cs684-2018/Smart-Fault-Monitoring-Device/Documentation/Presentation/SFMD_Proj_Presentation.pdf

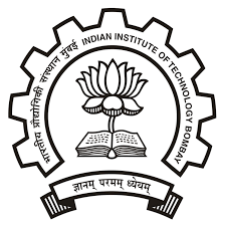
[picture p19: figure]

# Smart Fault Monitoring Device

Guide
Prof. Kavi Arya
Mr. Naveen Cherupally

Group Members
Abhishek Pal -173074015
Anil Kumar Garg -173074018

CS 684 - Embedded Systems
Spring 2018

## Problem Statement

Objective

- A Smart Fault Monitoring Device can be used for monitoring the trip/fault status across MCB in domestic and industrial safety application.
- This will log trip information and intimate to user using IoT device.

Product Impact

- All residential and commercial establishments.
- Be a part of Smart City initiative.

## Scheme

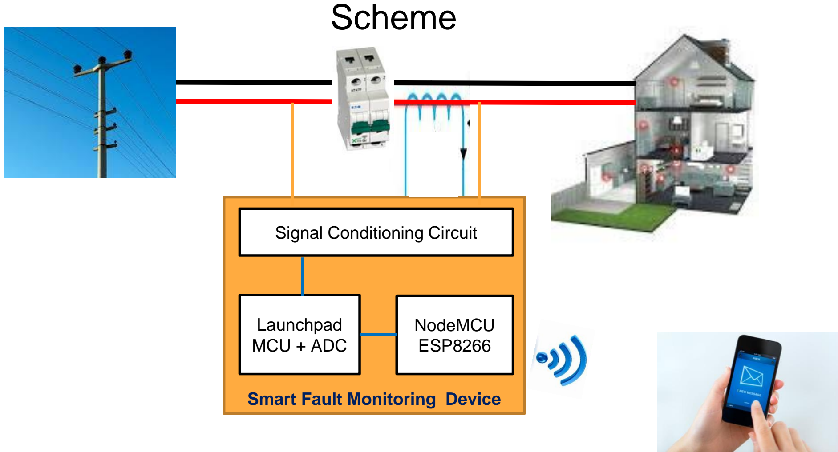
[picture p20: page 3]

Smart Fault Monitoring Device

Launchpad
MCU + ADC

Signal Conditioning Circuit

NodeMCU
ESP8266

## Actual Product Realized

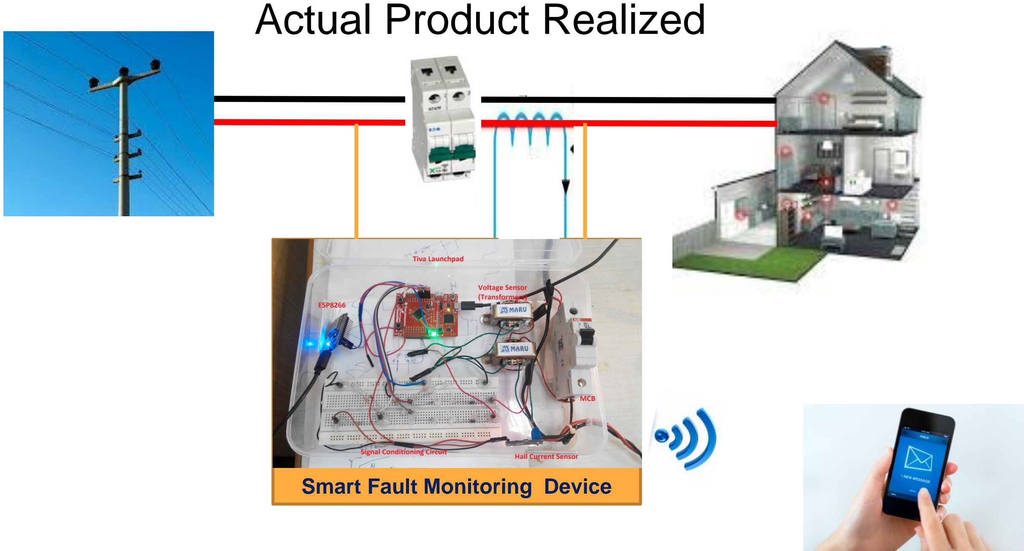
[picture p21: page 4]

Smart Fault Monitoring Device

Launchpad
MCU + ADC

Signal Conditioning Circuit

NodeMCU
ESP8266

## Signal Conditioning

## Schematic

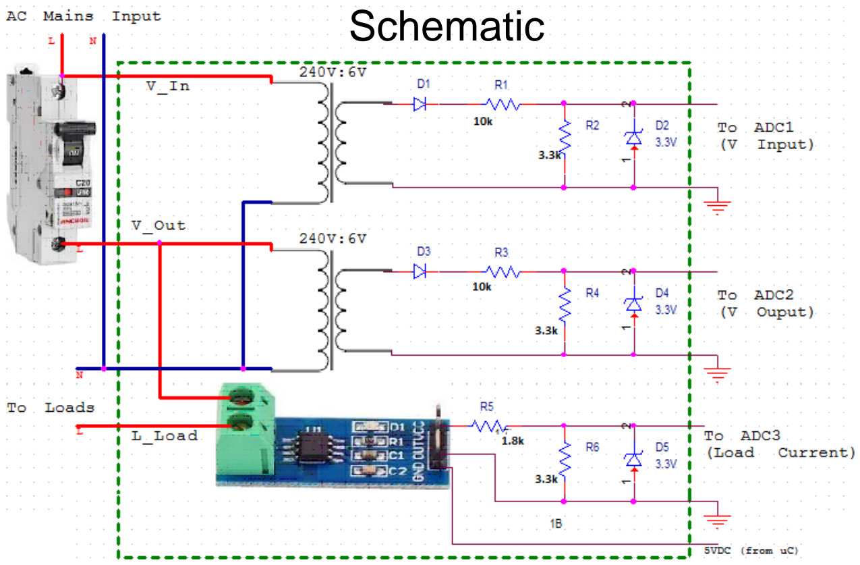
[picture p22: page 5]

## Power Status Monitoring

- Power OK : Voltages on Primary & Secondary side of MCB are OK.
- No Power: Mains supply is not coming.
- MCB Tripped: MCB got tripped due to overcurrent, short circuit etc.

## Requirements

Hardware
- ESP8266 NodeMCU
- Tiva Series Launchpad
- AC Voltage Sensor (Step down Transformer)
- AC Current Sensor (ACS712)
- Signal Conditioning Board
- 5VDC Supply

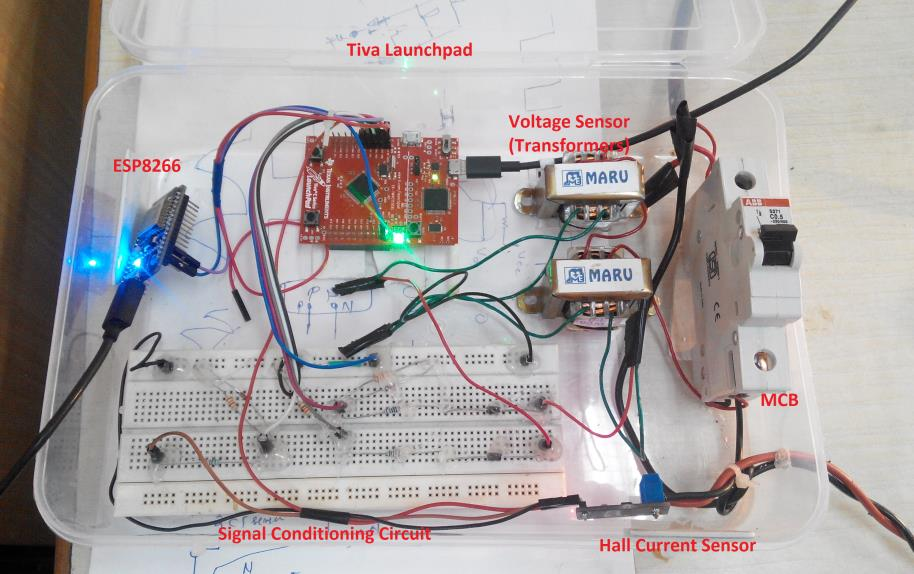
[picture p23: figure]

Software
- CCS 6.1.2
- MOS (for IoT Device)
- AWS Platform (e-yantra)
- Serial Console

## Challenges

Challenges
- Safety precaution to be followed, while working with live voltages.
- Hardware selection for Wireless communication.
- Sensor selection for AC current and voltage.
- Sensor calibration
- Real time DC offset calibration.
- Exploring web/email interface for user notification
- Acquiring the skills for the IoT device programming (MOS/mJS)

## Deliverables

- Smart Fault Monitoring Unit
- Microcontroller board with ADC/sensors
- IoT device
- Analog signal conditioning hardware
- Front-end interface(IoT platform)

## Test Strategies

- Measurement Tests : To verify measured input current and voltage values
- Fault Monitoring and Test : To verify the detection of MCB trip contact status
- Communication Test: Send the fault/trip alert to the user via internet/AWS
- Front-end testing

## Test Results ..1

- ACS712 - 30A Current

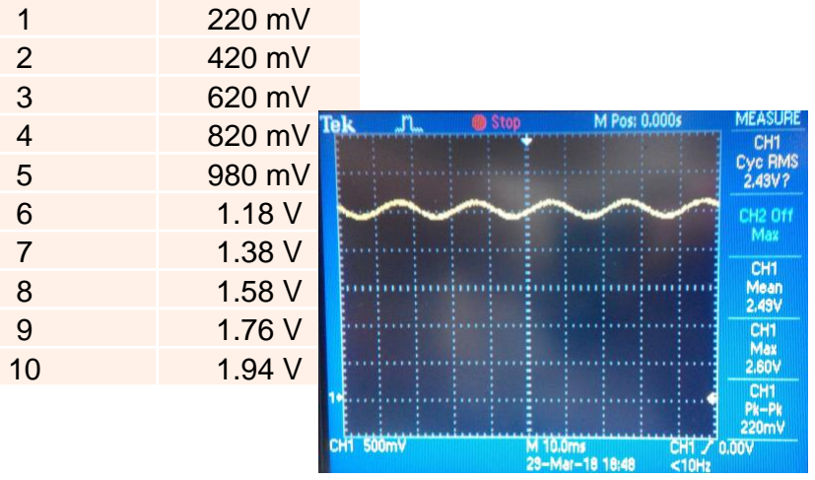
[picture p24: figure]

Sensor

Ip (Input), Amp (rms) | Sensor O/P Volt (Vpp)
0.25 | 56.8mV
0.5 | 101mV
- Voltage Sensor

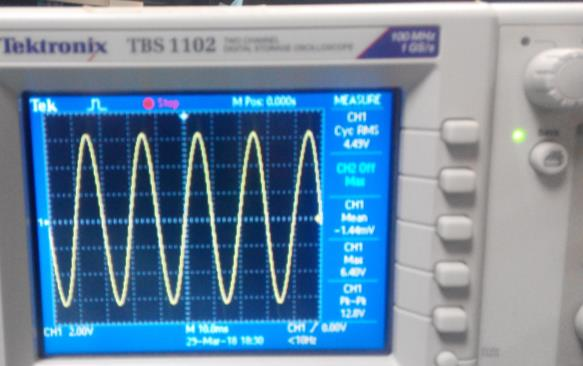
[picture p25: figure]

Primary Volt | Secondary Volt
240 Vrms | +/-10.6 V

## Test Results ..2

- Tiva | ● ESP
Timer Interrupt Generation & Verification | Done
ADC SoC Generation & Data read Verify | Done
Volt/Current RMS calculation logic | Done
Fault status decoding logic | Done
Fault intimation on UART | Done

ESP8266
Arduino IDE & library installation | Done
ESP programming procedure | Done
ESP UART communication with Tiva | Done
ESP Wifi Comm. | Done
ESP Notification Sending | Done
Web/Email | Done
IoT Platform (AWS) Interface | Done

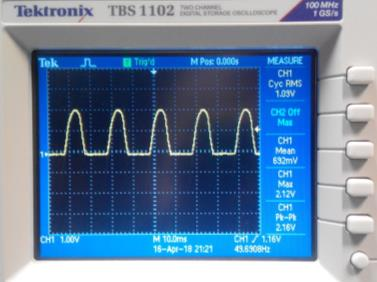
[picture p26: figure]
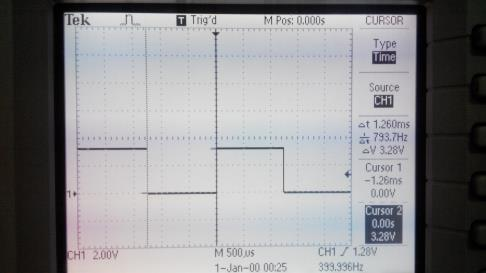
[picture p27: figure]
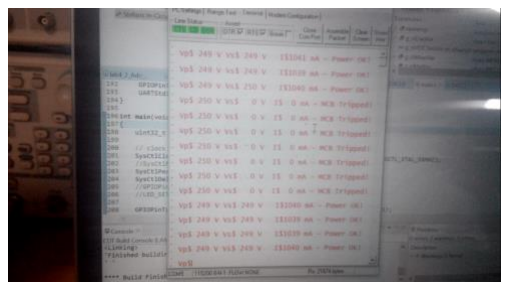
[picture p28: figure]

## Integrated Test Setup

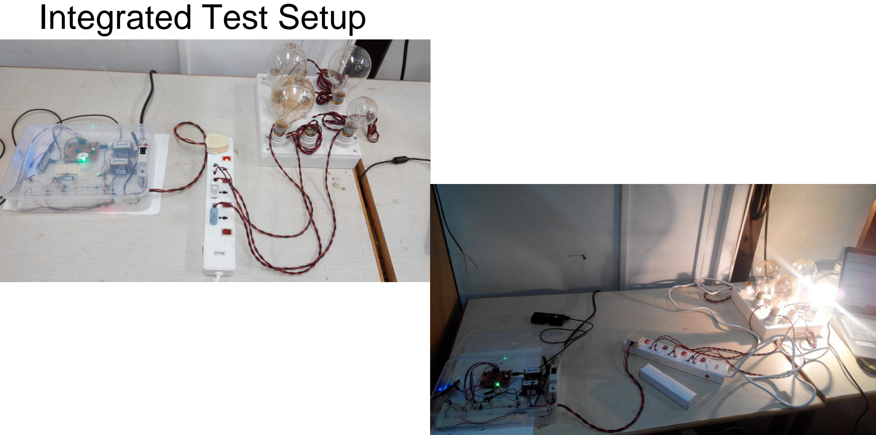
[picture p29: page 13]

## Dashboard (Power OK - Normal State)

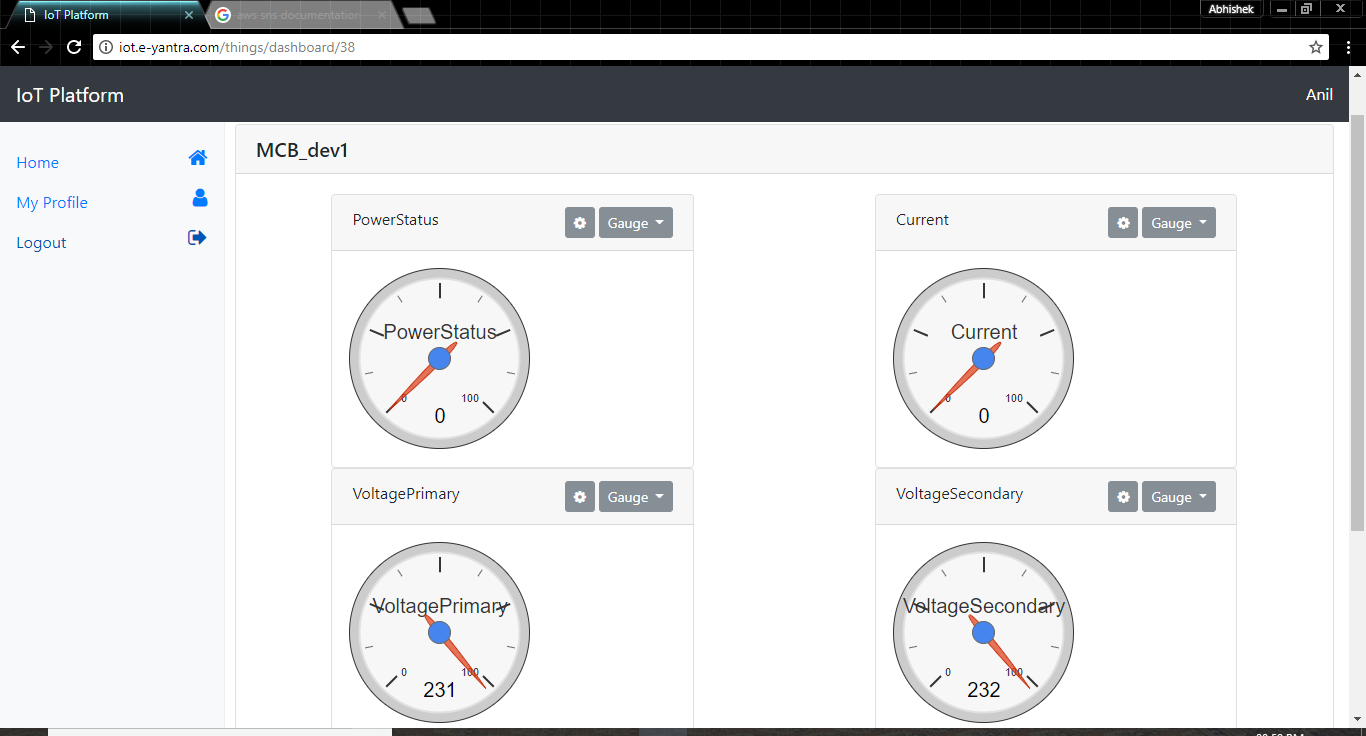
[picture p30: figure]

## Dashboard (No Power State)

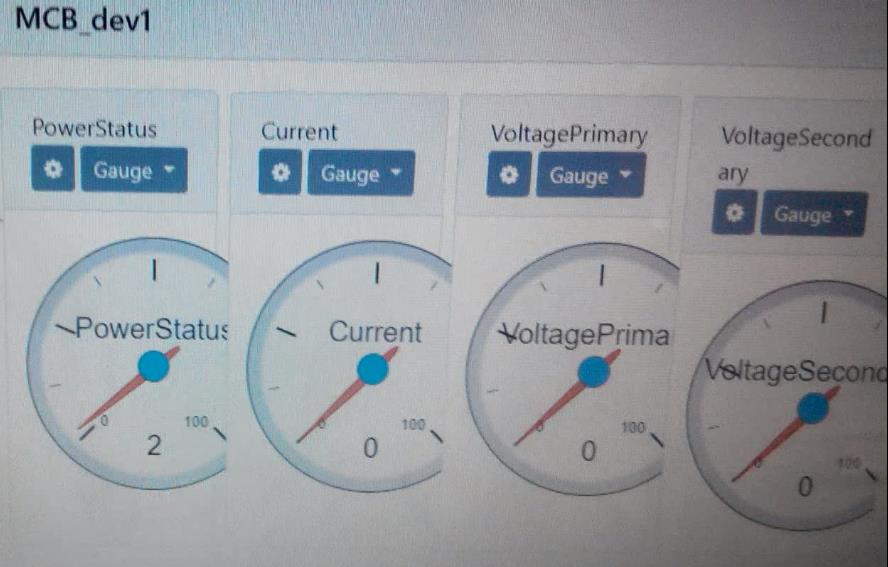
[picture p31: figure]

## Dashboard (MCB Tripped State)

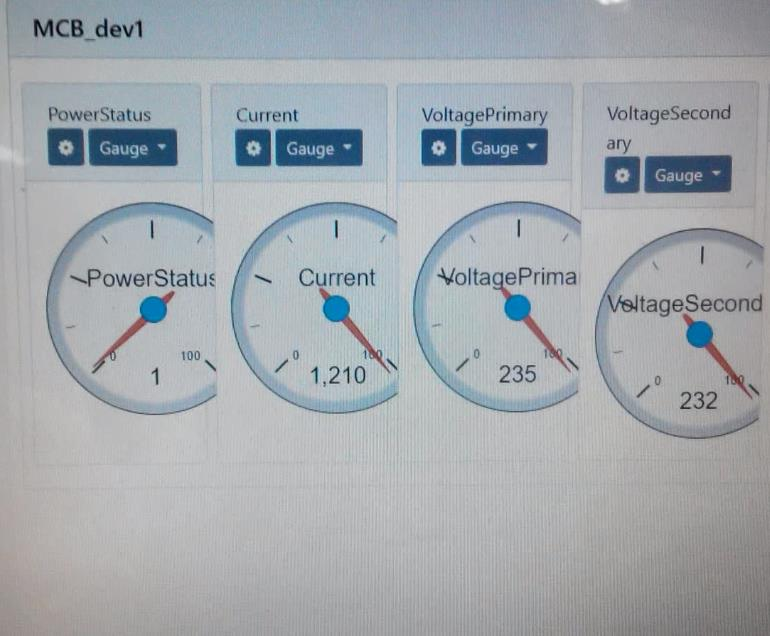
[picture p32: figure]

## Alternate Dashboard (Time History – Normal State)

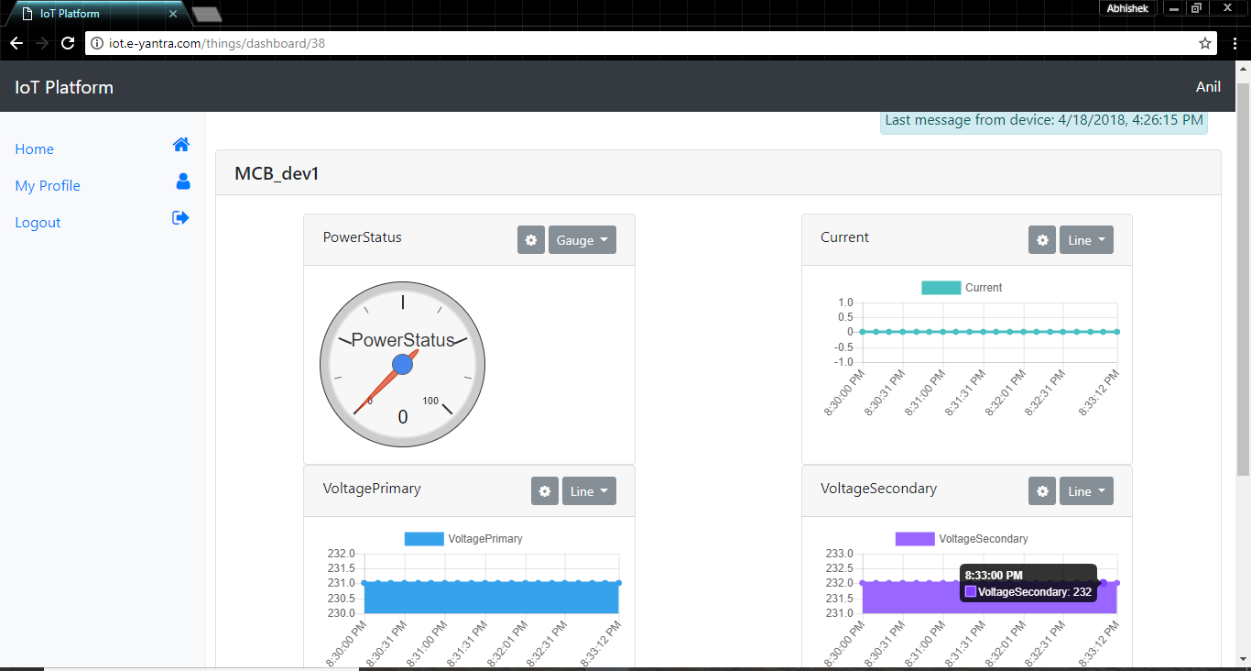
[picture p33: page 17]

## Email Notifications

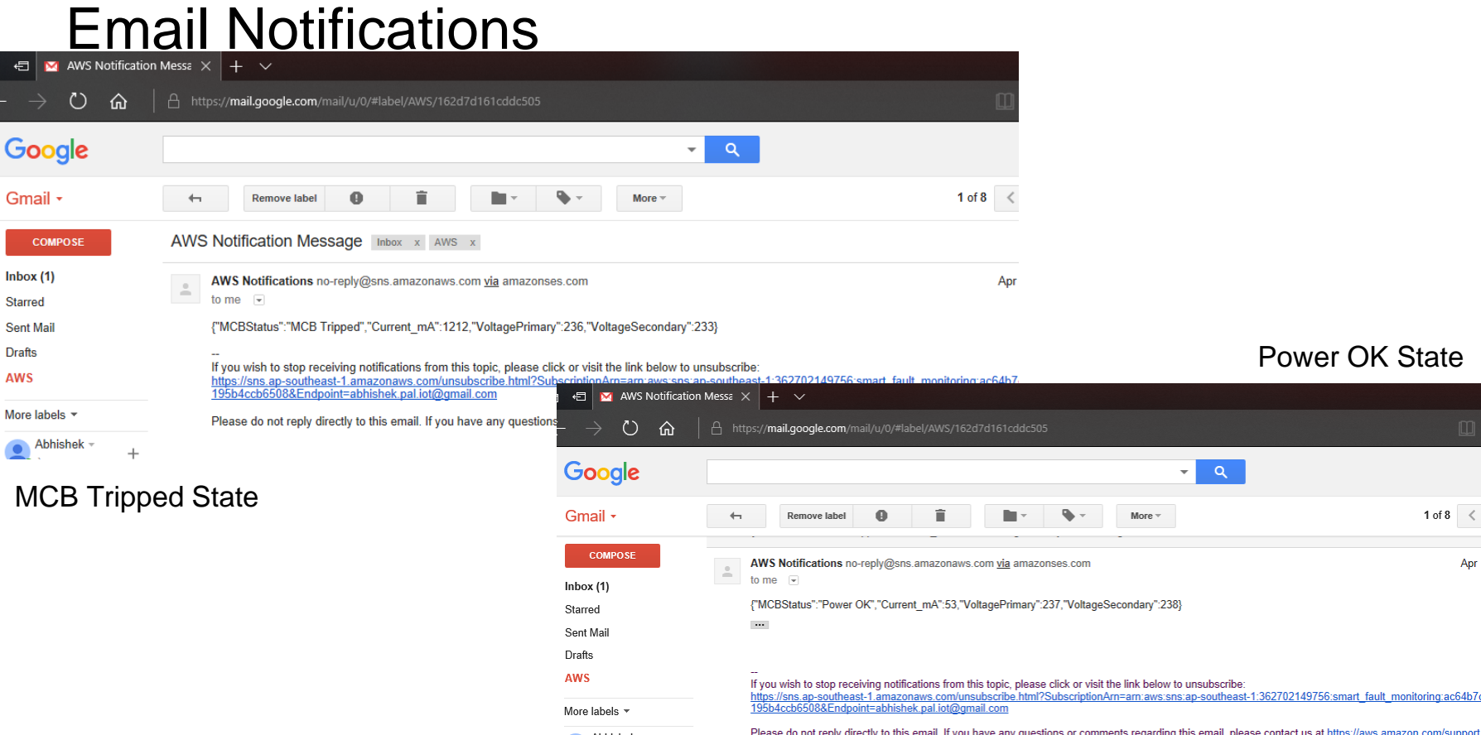
[picture p34: page 18]

MCB Tripped State

Power OK State

## Timeline

Activity | Timeline (EDC)
Project Discussion & Finalisation | 2 nd Week – March’18
Component & Sensor Selection | 3 rd Week – March’18
Component & Sensor Ordering & Receipt | 3 rd- 4 th Week – March’18
Component/Sensor Testing | th Week – March’18 4-5
Coding & testing – Microcontroller (measurement & processing) | 4-5 th Week – March’18
Communication with microcontroller & IoT device | 1 st Week – April’18
Front-end development & communication with IoT | 2 nd Week – April’18
Integrated Testing | 3 rd Week – April’18
Final Presentation | 18th April, 2018

## Expected output & Status

- Real time data acquisitions of current and voltage : Done
- MCB contact monitoring : Trip or No trip : Done
- Data display on e-yantra IoT platform : Done
- Alert message to user : Done

## Approach

- Real time data acquisitions of current and voltage :
- Collected 16 samples/ cycle (20 millisecond time) and calculated RMS value
- Buffered all samples of all channels for debugging purpose.
- Calibration of all current and voltage channels.
- Runtime DC offset removal logic from input AC signal
- Latching data whenever fault occurs
- MCB contact monitoring :
- Implemented logic to derive MCB tripped /power supply status

Approach..

- Data display on e-yantra IoT platform
- Acquiring the skills for the IoT device programming (MOS/mJS)
- Establishing internet communication of ESP8266 with e-yantra/AWS using MOS
- Communication interface between ESP8266 and TIVA board
- Massage frame formatting and parsing data into JSON string format.
- Sending data from Tiva to ESP via UART.
- Alert message to user
- E-yantra IoT platform (AWS SNS service)
- Email notification

## Issue Faced

- Synchronization issue of latched data with pre tripped input signal.
- Exploring options for programming the ESP (Arduino/Mongoose OS)
- String parsing in mJS & extracting the parameter values
- ESP UART0 is driven by USB & GPIO both. Only one can drive at a time.
- UART0 also used for system message logs. So ‘SetDispatcher’ API stops triggering, once ESP connects to WiFi. Otherwise in offline condition it was working
- Resolution: Used polling method by a timer to read UART data & flush the UART buffer for next reception
- I2C in master mode tested, but had some issues of interrupt handling using Tiva as I2C slave.
- Some times IoT (e-yantra/AWS) server link was down (mostly in evening time). However it was restored later on.

## Feature Enhancement

- Android application for easily accessibility
- Universal device for all rating of MCBs
- OTA (Remote firmware upgrade)
- Oscillography during tripping
- Data logging
- Higher precise power analyser for metering application
- Earth fault monitoring system

# Thank You
