cs684-2018/Smart-Fault-Monitoring-Device/Lab Experiments/readme.txt

member1
Name: Abhishek Pal (173074015)

member2
Name: Anil Garg (173074018)

All the lab experiments done areuploaded in respective member's folder
Folders are named as student_roll_no.
Added a well documented and commented code of your experiments in the respective folders.

(Note: These lab exeperiments were already being uploaded in respective member's github
repository after conducting each lab experiments).
