cs684-2018/Smart-Fault-Monitoring-Device/(list of files, drawings)

Other design files:
Documentation/Schematic/SFMD_Schematic.DSN
