cs684-2018/Smart-Fault-Monitoring-Device/Lab Experiments/173074015_Abhishek/Experiment3/LAB3P2.c

/*

Name: Anil Kumar Garg : 173074018
Name: Abhishek Pal : 173074015

Course Name: CS684-2018

Problem: 

1. When switch 1 is pressed the motor should rotate by ten degrees clockwise.
2. When switch 2 is pressed the motor should rotate by ten degrees anti-clockwise.
3. While doing the above two actions check for limits of the servo motor. It should no
move beyond the operating range.
4. Also use the debouncing method that you have learned in lab 2 for interfacing the
switch.


 */

#include <stdint.h>
#include <stdbool.h>
#include "inc/hw_memmap.h"
#include "inc/hw_types.h"
#include "driverlib/sysctl.h"
#include "driverlib/gpio.h"
#include "driverlib/debug.h"
#include "driverlib/pwm.h"
#include "driverlib/pin_map.h"
#include "inc/hw_gpio.h"
*/

volatile uint8_t ui8Adjust;

#define PWM_FREQUENCY 55
int main(void)
{
	volatile uint32_t ui32Load;
	volatile uint32_t ui32PWMClock;

	ui8Adjust = 83;
	SysCtlClockSet(SYSCTL_SYSDIV_5|SYSCTL_USE_PLL|SYSCTL_OSC_MAIN|SYSCTL_XTAL_16MHZ);
	SysCtlPWMClockSet(SYSCTL_PWMDIV_64);
	SysCtlPeripheralEnable(SYSCTL_PERIPH_PWM1);
	SysCtlPeripheralEnable(SYSCTL_PERIPH_GPIOD);
	SysCtlPeripheralEnable(SYSCTL_PERIPH_GPIOF);
	GPIOPinTypePWM(GPIO_PORTD_BASE, GPIO_PIN_0);
	GPIOPinConfigure(GPIO_PD0_M1PWM0);
	HWREG(GPIO_PORTF_BASE + GPIO_O_LOCK) = GPIO_LOCK_KEY;
	HWREG(GPIO_PORTF_BASE + GPIO_O_CR) |= 0x01;
	HWREG(GPIO_PORTF_BASE + GPIO_O_LOCK) = 0;
	GPIODirModeSet(GPIO_PORTF_BASE, GPIO_PIN_4|GPIO_PIN_0, GPIO_DIR_MODE_IN);
	GPIOPadConfigSet(GPIO_PORTF_BASE, GPIO_PIN_4|GPIO_PIN_0, GPIO_STRENGTH_2MA, GPIO_PIN_TYPE_STD_WPU);
	ui32PWMClock = SysCtlClockGet() / 64;
	ui32Load = (ui32PWMClock / PWM_FREQUENCY) - 1;
	PWMGenConfigure(PWM1_BASE, PWM_GEN_0, PWM_GEN_MODE_DOWN);
	PWMGenPeriodSet(PWM1_BASE, PWM_GEN_0, ui32Load);
	PWMPulseWidthSet(PWM1_BASE, PWM_OUT_0, ui8Adjust * ui32Load / 1000);
	PWMOutputState(PWM1_BASE, PWM_OUT_0_BIT, true);
	PWMGenEnable(PWM1_BASE, PWM_GEN_0);
	while(1)
	{
		if( GPIOPinRead(GPIO_PORTF_BASE,GPIO_PIN_4)==0x00)
		{
			ui8Adjust--;
			if (ui8Adjust < 56)
			{
				ui8Adjust = 56;
			}
			PWMPulseWidthSet(PWM1_BASE, PWM_OUT_0, ui8Adjust * ui32Load / 1000);
		}
		if( GPIOPinRead(GPIO_PORTF_BASE,GPIO_PIN_0)==0x00)
		{
			ui8Adjust++;
			if (ui8Adjust > 111)
			{
				ui8Adjust = 111;
			}
			PWMPulseWidthSet(PWM1_BASE, PWM_OUT_0, ui8Adjust * ui32Load / 1000);
		}
		SysCtlDelay(100000);
	}
}


void Timer0IntHandler(void)
{

}
void Timer1IntHandler(void)
{

}


void Timer2IntHandler(void)
{

}
