cs684-2018/Smart-Fault-Monitoring-Device/Lab Experiments/173074015_Abhishek/Experiment4/lab4_Adc_Uart.c

/*
 * Course : CS-684
 * Lab 4 : Joystick reading with Adc & Send to UART 
 * Submitted By:
 *            Abhishek Pal: Roll# 173074015
 *			  Anil Garg : Roll# 173074018
 */

#include <stdio.h>
#include <stdint.h>
#include <stdbool.h>
#include "inc/hw_ints.h"
#include "inc/hw_memmap.h"
#include "inc/hw_types.h"
#include "driverlib/sysctl.h"
#include "inc/tm4c123gh6pm.h"
#include "driverlib/interrupt.h"
#include "driverlib/gpio.h"
#include "driverlib/timer.h"
#include "driverlib/systick.h"
#include "driverlib/adc.h"
#include "driverlib/rom.h"
#include "driverlib/debug.h"
#include <time.h>
#include <inc/hw_gpio.h>
#include "driverlib/ssi.h"
#include "driverlib/uart.h"


#define DISCRETE 0

uint32_t ui32ADC0Value[4];
uint32_t ui32ADC1Value[4];

volatile uint32_t ui32Avg0;
volatile uint32_t copy0;

volatile uint32_t ui32Avg1;
volatile uint32_t copy1;

volatile uint8_t digit0;
volatile uint8_t digit1;
volatile uint8_t digit2;
volatile uint8_t digit3;
volatile uint8_t digit4;
volatile uint8_t digit5;
volatile uint8_t digit6;
volatile uint8_t digit7;

void uart_char(char data)
{
    UARTCharPut(UART0_BASE, data);
}

int main(void) {
    // Disable Buzzer on PortC PIN4
    SysCtlPeripheralEnable(SYSCTL_PERIPH_GPIOC); //PortC GPIO
    GPIOPinTypeGPIOOutput(GPIO_PORTC_BASE, GPIO_PIN_4);
    GPIOPinWrite(GPIO_PORTC_BASE, GPIO_PIN_4, 0x10);

    //Set Peripherals
    SysCtlClockSet(SYSCTL_SYSDIV_5|SYSCTL_USE_PLL|SYSCTL_OSC_MAIN|SYSCTL_XTAL_16MHZ);
    SysCtlPeripheralEnable(SYSCTL_PERIPH_ADC0); //Adc0
    SysCtlPeripheralEnable(SYSCTL_PERIPH_ADC1); //Adc1

    // ADCHardwareOversampleConfigure(ADC0_BASE, 64);

    // Set ADC0 Sequencer, Priority , Ch#
    ADCSequenceConfigure(ADC0_BASE, 1, ADC_TRIGGER_PROCESSOR, 0);
    ADCSequenceStepConfigure(ADC0_BASE, 1, 0, ADC_CTL_CH6);
    ADCSequenceStepConfigure(ADC0_BASE, 1, 1, ADC_CTL_CH6);
    ADCSequenceStepConfigure(ADC0_BASE, 1, 2, ADC_CTL_CH6);
    ADCSequenceStepConfigure(ADC0_BASE,1,3,ADC_CTL_CH6|ADC_CTL_IE|ADC_CTL_END);
    ADCSequenceEnable(ADC0_BASE, 1);

    // Set ADC1 Sequencer, Priority, Ch#
    ADCSequenceConfigure(ADC1_BASE, 1, ADC_TRIGGER_PROCESSOR, 0);
    ADCSequenceStepConfigure(ADC1_BASE, 1, 0, ADC_CTL_CH7);
    ADCSequenceStepConfigure(ADC1_BASE, 1, 1, ADC_CTL_CH7);
    ADCSequenceStepConfigure(ADC1_BASE, 1, 2, ADC_CTL_CH7);
    ADCSequenceStepConfigure(ADC1_BASE,1,3,ADC_CTL_CH7|ADC_CTL_IE|ADC_CTL_END);
    ADCSequenceEnable(ADC1_BASE, 1);

    // Set Pripheral UART on GPIO_A
    SysCtlClockSet(SYSCTL_SYSDIV_4 | SYSCTL_USE_PLL | SYSCTL_OSC_MAIN | SYSCTL_XTAL_16MHZ);
    SysCtlPeripheralEnable(SYSCTL_PERIPH_UART0); //Uart
    SysCtlPeripheralEnable(SYSCTL_PERIPH_GPIOA); //GPIO_A for UART
    //GPIOPinConfigure(GPIO_PA0_U0RX);
    //GPIOPinConfigure(GPIO_PA1_U0TX);
    GPIOPinTypeUART(GPIO_PORTA_BASE, GPIO_PIN_0 | GPIO_PIN_1);
    UARTConfigSetExpClk(UART0_BASE, SysCtlClockGet(), 115200,
                        (UART_CONFIG_WLEN_8 | UART_CONFIG_STOP_ONE | UART_CONFIG_PAR_NONE));

    while (1)
    {
        //if (UARTCharsAvail(UART0_BASE)) UARTCharPut(UART0_BASE, UARTCharGet(UART0_BASE));
        // Clear Adc Sequencer Interrupts & Trigger by CPU
        ADCIntClear(ADC0_BASE, 1);
        ADCProcessorTrigger(ADC0_BASE, 1);
        ADCIntClear(ADC1_BASE, 1);
        ADCProcessorTrigger(ADC1_BASE, 1);

        // Wait for Adc End of Conversion
        while(!ADCIntStatus(ADC0_BASE, 1, false))
        {
        }
        while(!ADCIntStatus(ADC1_BASE, 1, false))
        {
        }

        //Read Adc Samples from Sequencer
        ADCSequenceDataGet(ADC0_BASE, 1, ui32ADC0Value); //Read Adc0 Data 4 samples
        ADCSequenceDataGet(ADC1_BASE, 1, ui32ADC1Value); //Read Adc1 Data 4 samples

        //Average the 4 samples with 2/4 = +/-0.5 rounding
        ui32Avg0 = (ui32ADC0Value[0] + ui32ADC0Value[1] + ui32ADC0Value[2] + ui32ADC0Value[3] + 2)/4;
        copy0=ui32Avg0;
        ui32Avg1 = (ui32ADC1Value[0] + ui32ADC1Value[1] + ui32ADC1Value[2] + ui32ADC1Value[3] + 2)/4;
        copy1=ui32Avg1;

        // If only 5 discrete values to be sent over Uart
#if DISCRETE
        digit0 = 1;
        digit1 = 1;

        if (ui32Avg0 < 2000)
        {
            digit0 = 0;
        }

        if (ui32Avg0 > 2070)
        {
            digit0 = 2;
        }

        if (ui32Avg1 < 2000)
        {
            digit1 = 0;
        }

        if (ui32Avg1 > 2060)
        {
            digit1 = 2;
        }
        digit0 += 48; // Add 48 for ASCII char
        digit1 += 48; // Add 48 for ASCII char

        uart_char(digit0);
        uart_char(',');
        uart_char(digit1);
        uart_char('\n');
#endif

        //If continuous (12-bit) samples to be sent as 4 ASCII char
#if !DISCRETE
        digit0=copy0%10+48; // Add 48for ASCII char
        copy0=copy0/10;
        digit1=copy0%10+48;
        copy0=copy0/10;
        digit2=copy0%10+48;
        copy0=copy0/10;
        digit3=copy0%10+48;
        copy0=copy0/10;
        digit4=copy1%10+48;
        copy1=copy1/10;
        digit5=copy1%10+48;
        copy1=copy1/10;
        digit6=copy1%10+48;
        copy1=copy1/10;
        digit7=copy1%10+48;
        copy1=copy1/10+48;

        uart_char(digit3);
        uart_char(digit2);
        uart_char(digit1);
        uart_char(digit0);
        uart_char(',');
        uart_char(digit7);
        uart_char(digit6);
        uart_char(digit5);
        uart_char(digit4);
        uart_char('\n');
#endif
        //Add delay between serial frames
        SysCtlDelay(6700000); // 500ms delay

    }
}

void Timer0IntHandler(void) // Timer Interrupt routine
{

}
